lawsonkeith/budget-balance-bot/Readme.txt

Project: Budget Bot lite
Author:	 K Lawson
Date:	 6 May 2014

Description
-----------
Low cost balance bot platform.  This is a small; easy to build sub �50
robotic platform that can be controled (driven) using a bluetooth 
smartphone app.  The platform is optimised for those on a budget who 
still demand a cool looking robot with fake alloy wheels!!

Uses arduino mini pro; 9 DOF IMU and HC-05 as well as a L9110 motor controller.
