lawsonkeith/budget-balance-bot/atmode/Readme.txt

Code platform to program and HC-05 defaults using an arduino on breadboard or in the balancing robot.
