lawsonkeith/budget-balance-bot/BOM.txt

BOM for budget balance bot
--------------------------

K Lawson 
7 may 2014

Item	Desc					Cost 	Ref
--------------------------------------------------------------	
B1	8xAAA battery holder (open frame)	£02.58	Ebay 
F1	Fuse 2A					£01.00			
S1	Switch					£00.99	Maplin N19CL
U3	L9110 H Bridge				£00.99	Ebay
C1,2	100nF Cap 50V				£00.99	Ebay
M1,M2	6V 133RPM Motor Incl Wheels		£18.08	Ebay 
	JGA25-370-6V 133RPM
U4	Mini pro 16Mhz 3.3/5V enhancement	£05.95	Ebay
U1	HC-05 bluetooth transceiver		£03.35	Ebay
U2	9 DOF IMU GY85 ITG3205 ADXL345 MHC5883	£06.00	Ebay

O1	5x 2.54mm header sockets 6w		£01.19	Ebay
O2 	24pin DIP Socket for arduino		£01.50	Ebay
O3	Closed Slot Cable Trunking 25H 50W (mm)	Free issue
O4 	8xAAA Hybrio batteries			£11.00	Ebay
O5	Bumper - closed cell foam		Free issue
O6	Tie wraps 3mm				Free issue
O7 	2x5cm 3M Dual lock velcro		£01.80	Ebay	
O8	Child plug cover (IMU Mount)		£01.70	Ebay
O9	3mm Bolts and nuts x 2			£01.50 	Ebay 	
O10	Small card tube from kitchen (Motor)	Free issue
	For exampe off cling film roll.		

Notes
a. I used a SMT fuseholder and soldered it to the switch
b. The motors can be found on ebay if you search "6V 133rpm motor"
c. Make sure you use the 3M velcro; its miles better than the cheap stuff
d. I used Pro power cable trunking (I think) You can get various types off ebay.  You can also replace it with cardboard or plywood to save more money.
