lawsonkeith/budget-balance-bot/A0015_schematic.pdf

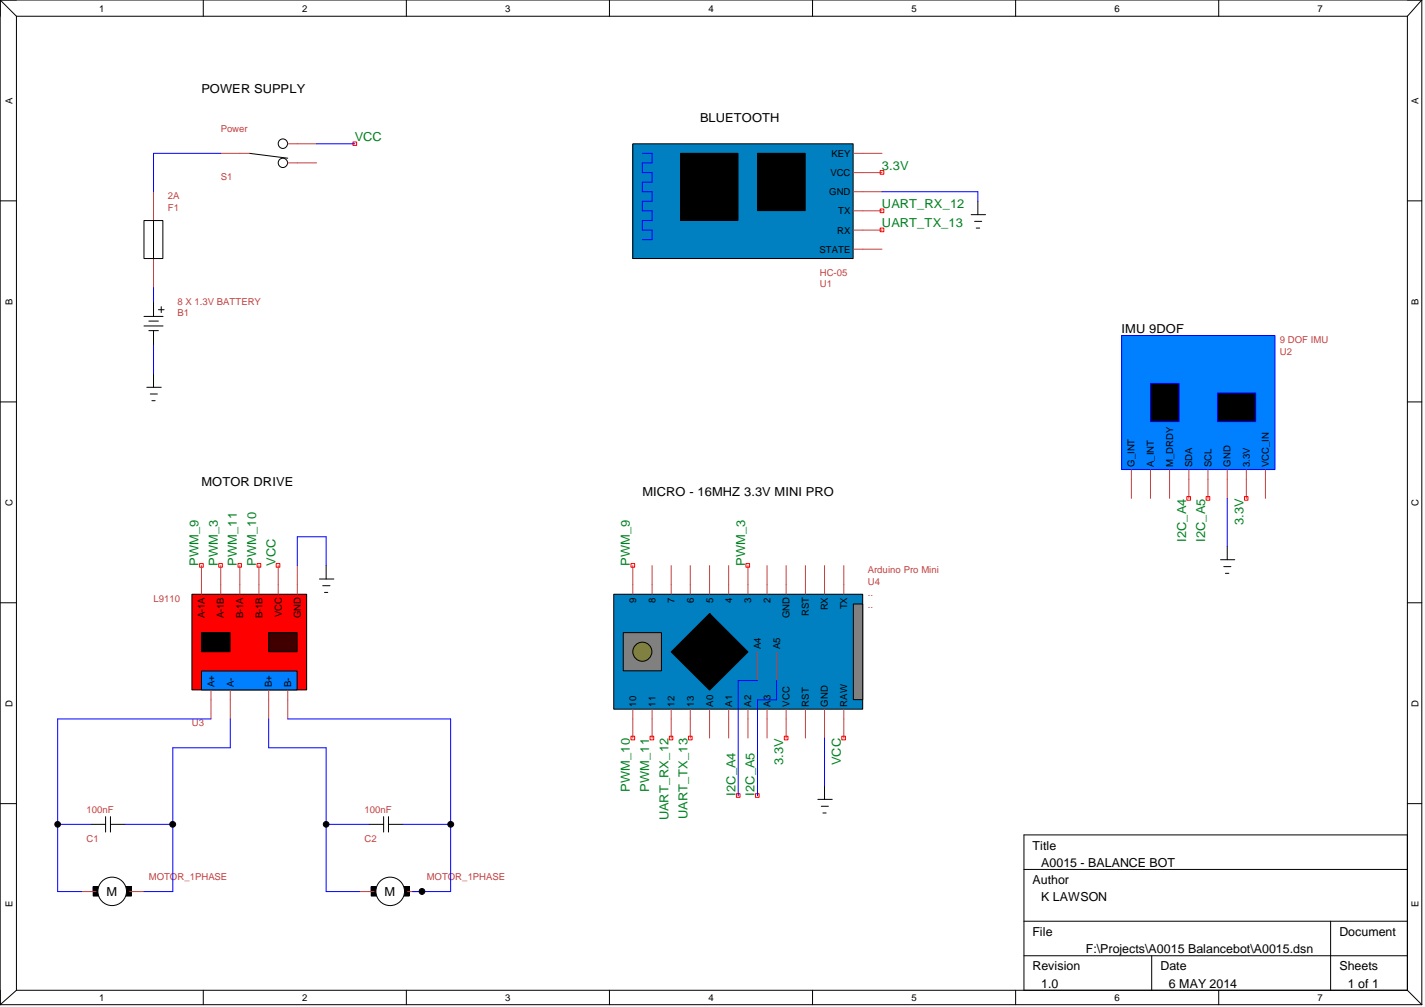
[picture p13: page 1]
G_INT; A_INT; M_DRDY; SDA; SCL; GND; VCC_IN; 9 DOF IMU; VCC; RST; RAW; Arduino Pro Mini; STATE; KEY; MOTOR_1PHASE; 8 X 1.3V BATTERY; Power; MOTOR DRIVE; POWER SUPPLY; PWM_9 PWM_10; PWM_11; UART_RX_12; PWM_9; PWM_3; PWM_10; BLUETOOTH; IMU 9DOF; UART_RX_12 UART_TX_13; UART_TX_13; Title; Author; A0015 - BALANCE BOT; K LAWSON

MICRO - 16MHZ 3.3V MINI PRO

File F:\Projects\A0015 Balancebot\A0015.dsn | Document

Revision 1.0 | Date 6 MAY 2014 | Sheets 1 of 1
