lawsonkeith/budget-balance-bot/(commit log)

2014-05-08 Fixed dox errors
    [Vehicle dynamics.xls]
2014-05-18 added pid pic
